kkoppul2/bilbot_baggins/Final Presentation.pdf

# Survivor Identification and Retrieval Robot

## Karun Koppula Zachary Wasserman Zhijie Jin

## What Does it Solve?

- Rescue people/objects in situations that would be life threatening
- Grab a drink and bring it back

Does this by being:

- An autonomous vehicle that can navigate a maze
- Capable of identification of objects
- Capable of retrieving objects

## Original Design

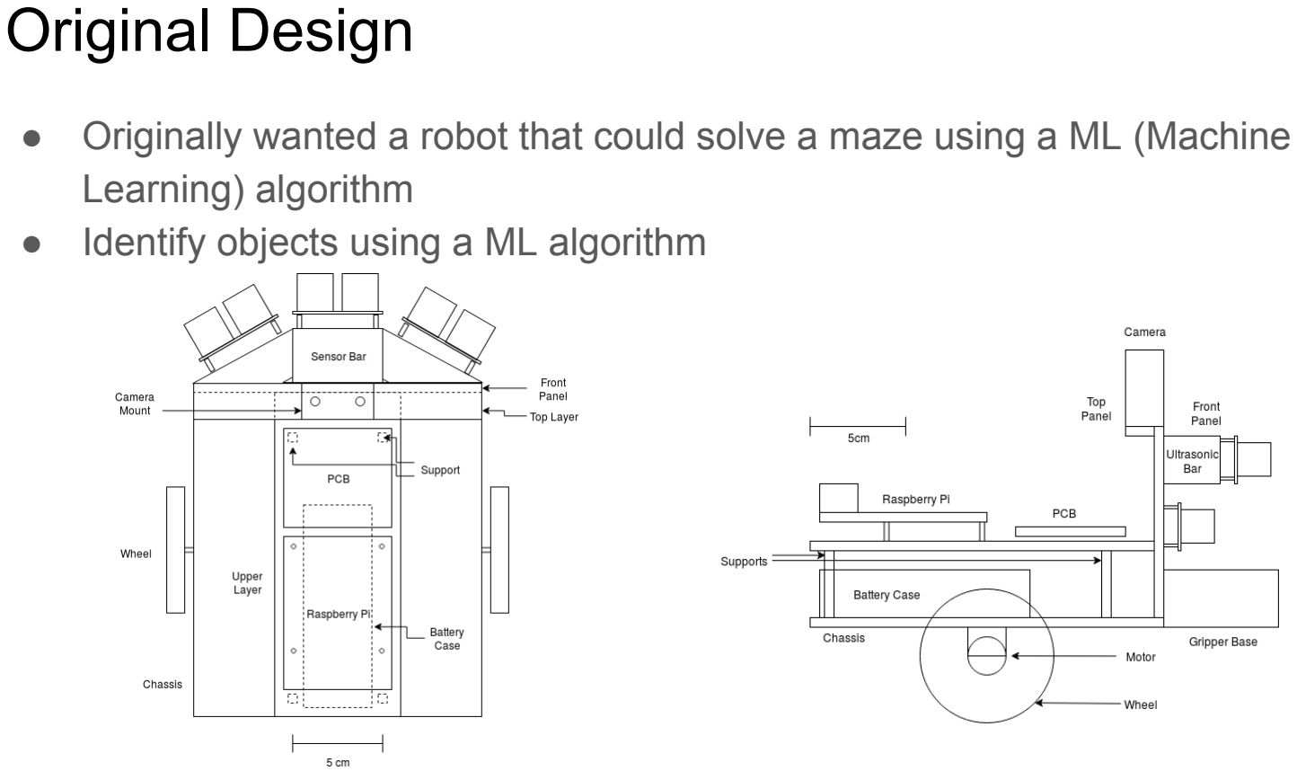
[picture p13: page 3]

- Originally wanted a robot that could solve a maze using a ML (Machine Learning) algorithm
- Identify objects using a ML algorithm

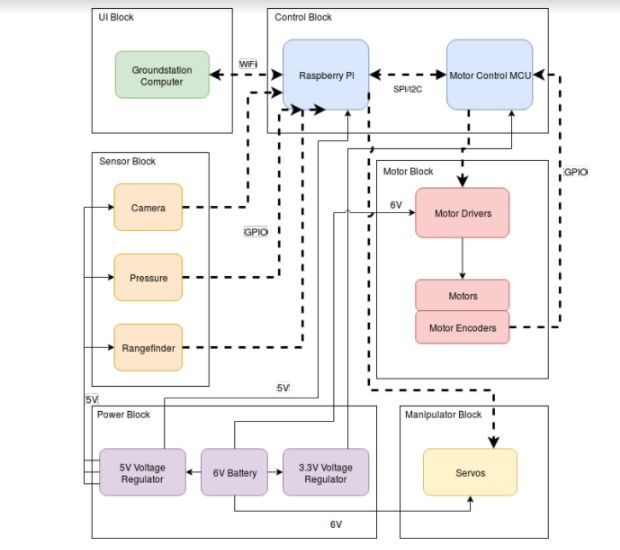
[picture p14: page 4]

## Detection/Classification

- Used Single Shot Detection (SSD)
- Need to know classification
- Need to know the localization
- Alternatives would include YOLO:9000 bigger,faster,stronger.

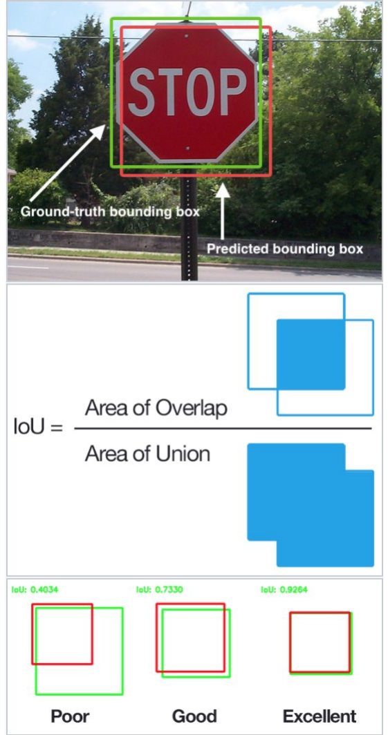
[picture p15: figure]

## How Single Shot Detection Works

- First determining the features of the image
- For each location use a filter to evaluate the boxes
- For each box, predict box and class
- Modify prediction values s.t. IoU closest to 1
- Also modify values so that the classifier is more correct
- Box Choices

multiBoxLoss=confidenceLoss+alpha*locationLoss

## Verification of Single Shot Detection Model

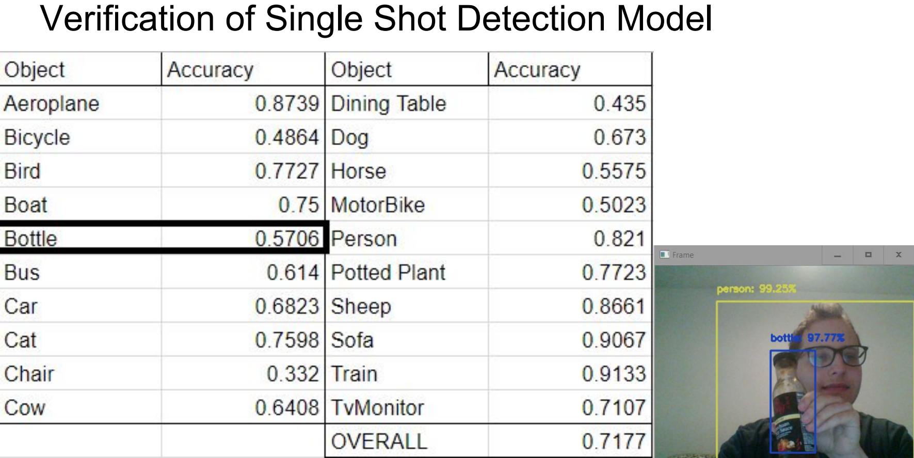
[picture p16: page 7]

## Retrieval

- Single Shot Detection passes the pixel coordinates of where the object exists on the screen
- Take these coordinates and calculate degrees to turn
- Rotate s.t. the two are lined up
- Use Ultrasonic sensor to move forward
- Use servo to pick up object

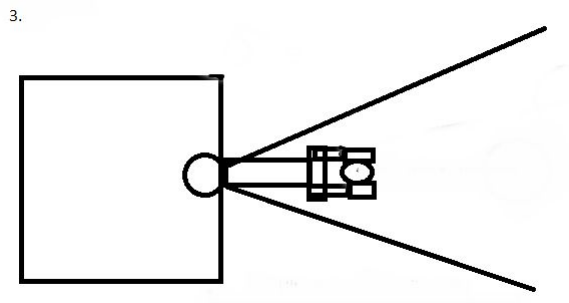
[picture p17: figure]
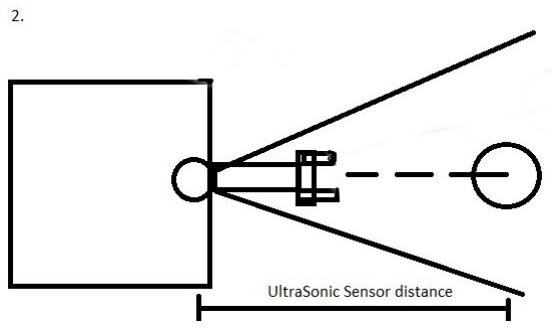
[picture p18: figure]
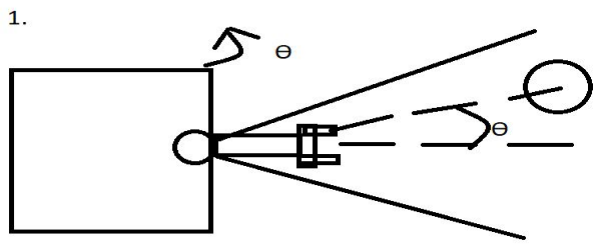
[picture p19: figure]

## Verification of Retrieval

- Checked console to see if the output of the pixel coordinates was reasonable
- Servo can be verified by using python commands to control them
- Measure distances using UltraSonic sensor

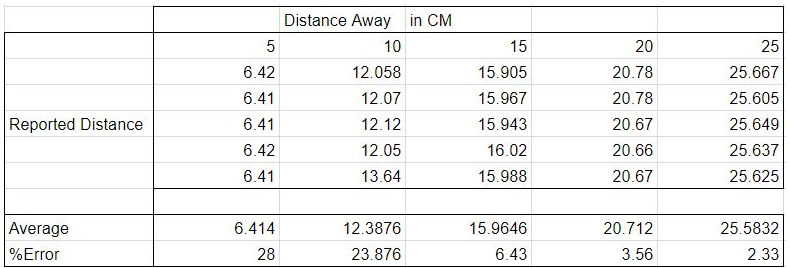
[picture p20: figure]

## How to find the degrees to turn

1. Get the “Half Frame in pixel distance
2. Find the middle horizontal point of the box drawn around the object
3. Subtract value from 2 by value from 1
4. Multiply by ratio of degrees/pixel
5. If turn left, multiply by -1

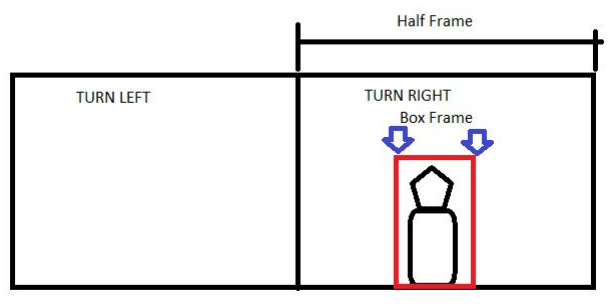
[picture p21: figure]

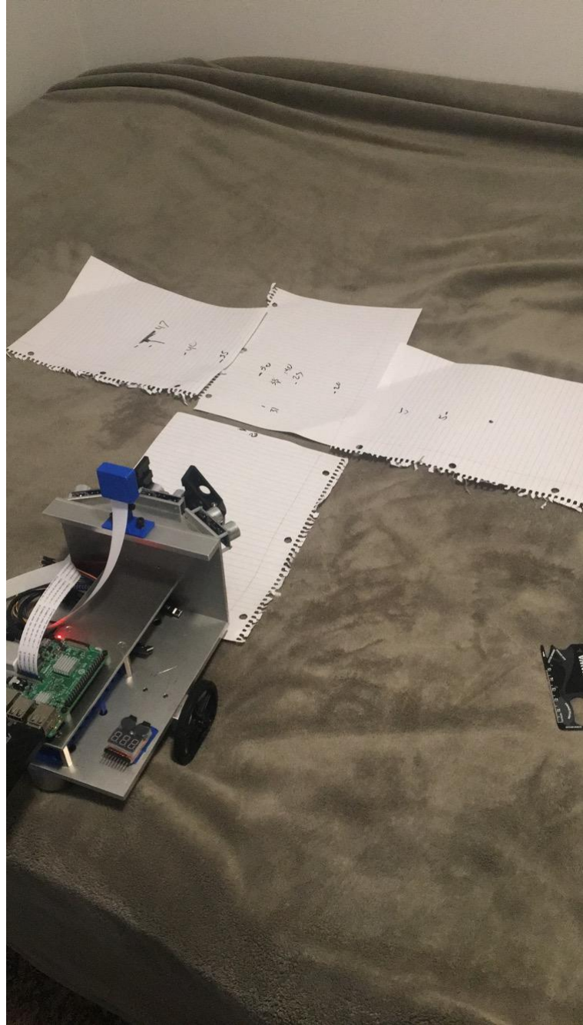
[picture p22: figure]

## Verification of Degrees to Turn

- My field of view calculation: 30.43 degrees
- Documentation: 31.1 degrees
- The horizontal pixel distance can be done in python
- Tested against real object, did math to see if match

## A* search algorithm

- First we analyze each node and determine distance to the end point from each node (Manhattan Distance)
- Follow path taking smallest weights at each node (sum of manhattan plus distance we have traveled to reach that point)
- When solved, passes the movement as ROS command

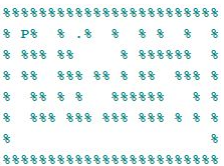
[picture p23: figure]

## Verification of A*

- Detailed proofs that declare it is optimal if it is both Admissible and Consistent (lecture in itself)
- Check against a Breadth-first search solution (left BFS right A*)

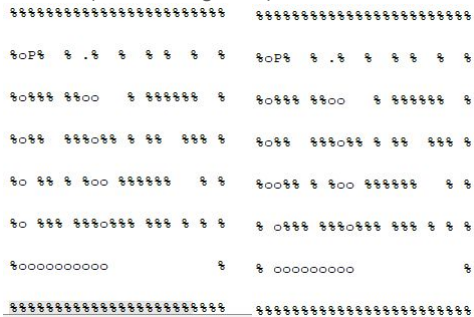
[picture p24: figure]

- On 7x5, A* is 8 times faster than BFS
- On 24x7, A* is 22 times faster
- On 82x31,A* is 21 times faster

## Range Finding

- Ultrasonic Sensors
- Noisy
- Object Detection
- Domain

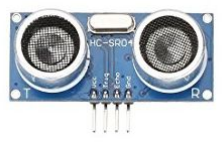
[picture p25: figure]

## Rotary Encoder

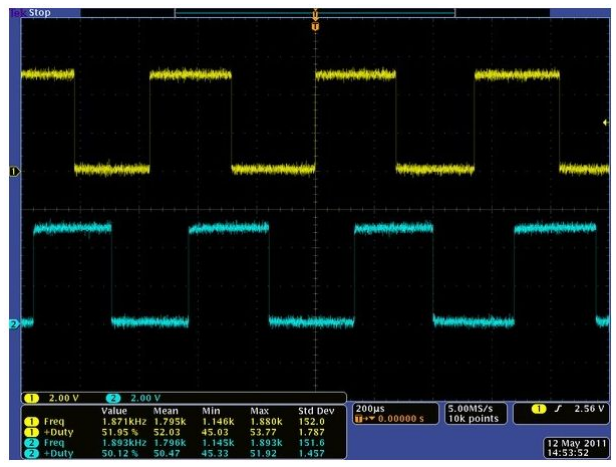
[picture p26: figure]

- Hall Effect
- Two square waves with 90 degree phase offset
- Used for direction, speed
- Angular resolution of 0.002794 radians

## Motor Control

- PID Control
- Non-linearities of velocity estimation
- Raspberry Pi non-realtime

## PCB Schematics & Layout

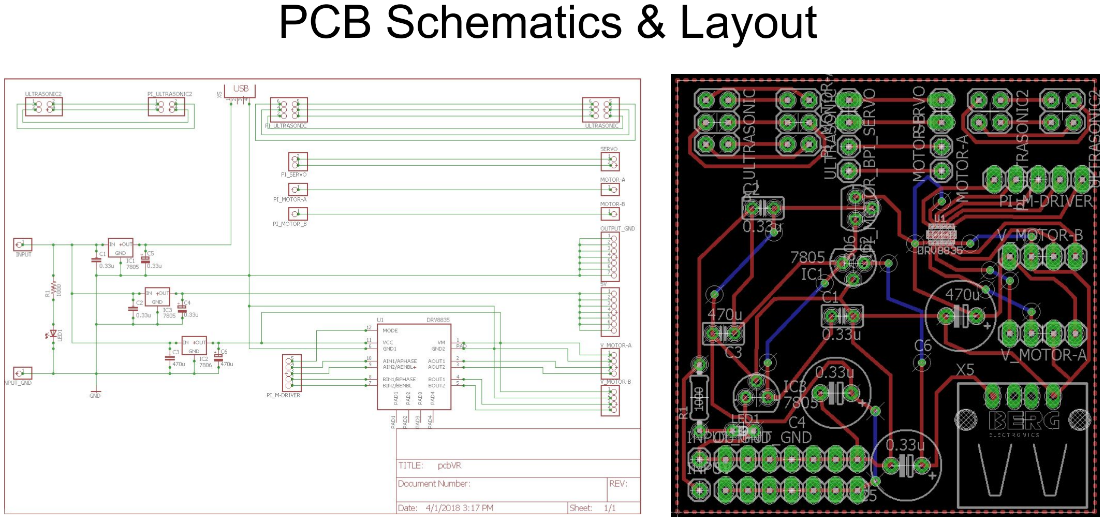
[picture p27: page 17]

## Voltage Regulator Circuit

Output voltage: 5V
Output current: 1.5A(max)

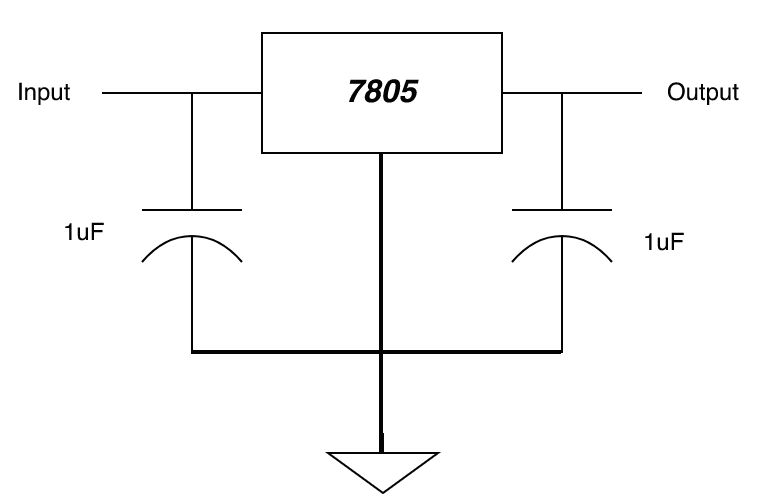
[picture p28: figure]

## High Current Voltage Regulator Circuit

From:

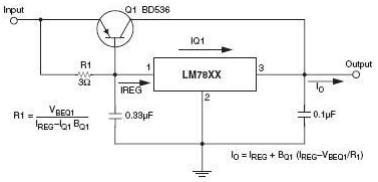
[picture p29: figure]

http://www.reuk.co.uk/wordpress/electric-circuit/high-current-voltage-regulation/

## PCB and Perfboard Layout (with soldering)

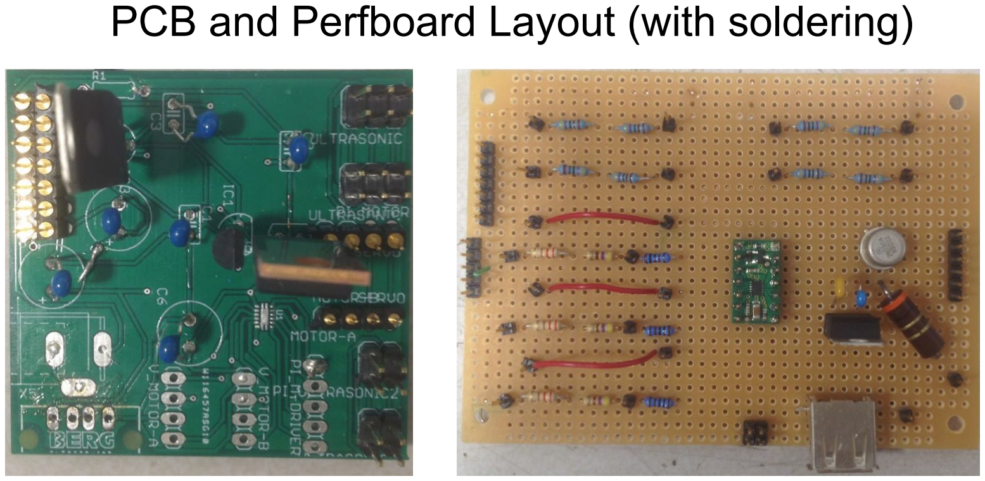
[picture p30: page 20]

## Power Calculation

Total power from battery: Pb = 2.2Ah = 24.42 Wh

Two motors: 9 W

Two servos: 0.768 W

Three ultrasonic sensors: 0.225 W

Raspberry Pi: 12.5 W

Power wasted by voltage regulator: 23.956 W

Operation time: 30 minutes

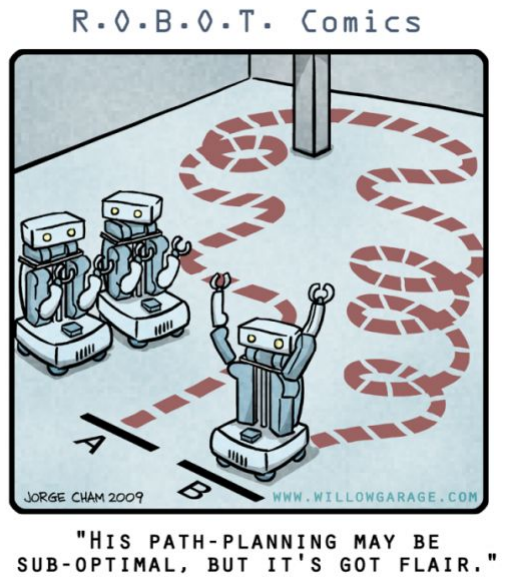
[picture p31: figure]

## Successes and Challenges

Successes:

- Robot turning
- SSD

Challenges:

- ROS
- Robot moving forward
- Training of the SSD

## Future Work

- Getting the movement fully finished
- Stress testing
- Better designed bot:
- Lighter
- Better Processor
- Better Gripper
