kkoppul2/bilbot_baggins/bilbot_description/meshes/battery_case.stl

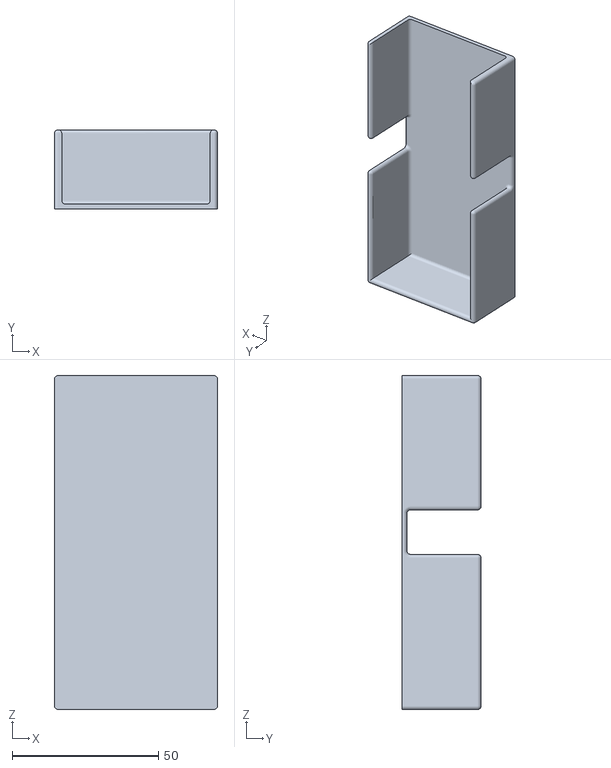
[picture p32: CAD file, 2018-04-15]
bilbot_description/meshes/battery_case.stl
55.9 x 27.2 x 114.3
