kkoppul2/bilbot_baggins/(commit log)

2018-03-25 added robot simulation packages
    [bilbot.xacro, macros.xacro, materials.xacro]
2018-04-15 Working on hardware interface
    [battery_case.stl, bilbot.xacro, macros.xacro]
2018-04-15 interface compiled
    [bilbot.xacro, macros.xacro]
2018-04-15 debug1 motor controller
2018-04-15 motor controller .h vs .hpp
2018-04-15 debug2 motor controller
2018-04-15 debug3 motor controller
2018-04-15 debug4 motor controller
2018-04-15 debug4 motor controller fixed subscribers
    [motor_controller.cpp, motor_output.cpp, wheel_state.cpp]
2018-04-15 debug4 motor controller subscribers were still terrible
2018-04-15 debug5 motor controller
2018-04-15 debug5 motor controller functions were private
2018-04-15 debug6 motor controller changed param to getParam
2018-04-16 debug1 encoder driver changed callback to member function
2018-04-16 debug2 encoder driver try to link pigpio
2018-04-16 debug2 encoder driver link pigpio second attempt
2018-04-16 maybe its a pointer issue?
    [wheel_state.cpp]
2018-04-16 missing bracket in merge class
    [merge.cpp, merge.hpp]
2018-04-16 isolated sudo issues to harware package
    [control.yaml]
2018-04-16 im so tired
2018-04-17 base case sudo issue
2018-04-18 changed encoder driver to pigpiod_if2
2018-04-18 fixed initial bugs with new library
    [rotary_encoder.cpp, rotary_encoder.hpp, wheel_state.cpp]
2018-04-18 missed other callback signature
    [rotary_encoder.hpp]
2018-04-18 changed motor controller node to new library
2018-04-18 fixed init and have daemon running properly
    [wheel_state.cpp]
2018-04-18 run encoder
2018-04-18 encoder without gpio
2018-04-18 encoder without writing message values
2018-04-18 encoder without anything
2018-04-19 encoder gdb
2018-04-19 encoder with publisher
2018-04-19 encoder issue with declaring message components
    [wheel_state.cpp]
2018-04-19 encoder resized message arrays
2018-04-19 motor controller hard code subscriber topics
2018-04-19 link interface with motor output nodes
2018-04-19 testing encoder node
2018-04-19 forgot to do velocity output for encoder nodes
2018-04-21 running encoder nodes
2018-04-21 both wheels reading same encoders
2018-04-21 testing velocity controller
2018-04-21 add init latched message for motor drive commands
2018-04-21 find min pwm signal
2018-04-21 added lower pwm limit
2018-04-21 added dynamic reconfigure for controller
    [controller.cfg]
2018-04-21 test dynamic reconfigure left motor
2018-04-21 testing velocity controller left motor connected
2018-04-21 set integral threshold
    [controller.cfg]
2018-04-22 added integral threshold to dynamic reconfigure
    [controller.cfg]
2018-04-22 tuned response testing on both wheels
    [controller.cfg]
2018-04-22 motors working controller tuned
2018-04-22 reduced velocity and acceleration limits
2018-04-22 added laser and ultrasonic
    [controller.cfg]
2018-04-22 add build for ultrasonic
2018-04-22 fix ultrasonic syntax errors
    [ultrasonic.cpp]
2018-04-22 added nonstatic callback to ultrasonic
2018-04-22 fix laser errors
2018-04-22 ultrasonic working set to 10 hz
2018-04-23 add static transform to map frame
2018-04-23 remove dynamic reconfig from motor controller
2018-04-23 try building without motor node
2018-04-24 add latched published to motor command
    [controller.cfg]
2018-04-24 no motor output
2018-04-24 publish motor command
2018-04-24 readd controller dynamic config
    [Controller.cfg]
2018-04-24 readd dynamic reconfigure to motor node
    [Controller.cfg]
2018-04-24 test motor launch with dynamic reconfigure
2018-04-24 ultrasonic only clearing
2018-04-24 testing only encoder and motor
2018-04-24 changed config params to not have .0
    [Controller.cfg]
2018-04-24 subscribed to wheel right
2018-04-24 added both encoders and merge to launch
2018-04-24 the wheels work again and im not sure why
2018-04-24 fixed acceleration and velocity limits
2018-04-24 increased min angular velocity
2018-04-24 higher min velocities
2018-04-24 created simple control law
    [Pos_Controller.cfg]
2018-05-02 increase controller gain range
    [Controller.cfg]
2018-05-04 update controller gains
    [Controller.cfg]
2018-05-04 kp up a bit
    [Controller.cfg]
